Cheng-netizen21/STM32-ESP8266-Env-Monitor/docs/OTA写入成功图片.png

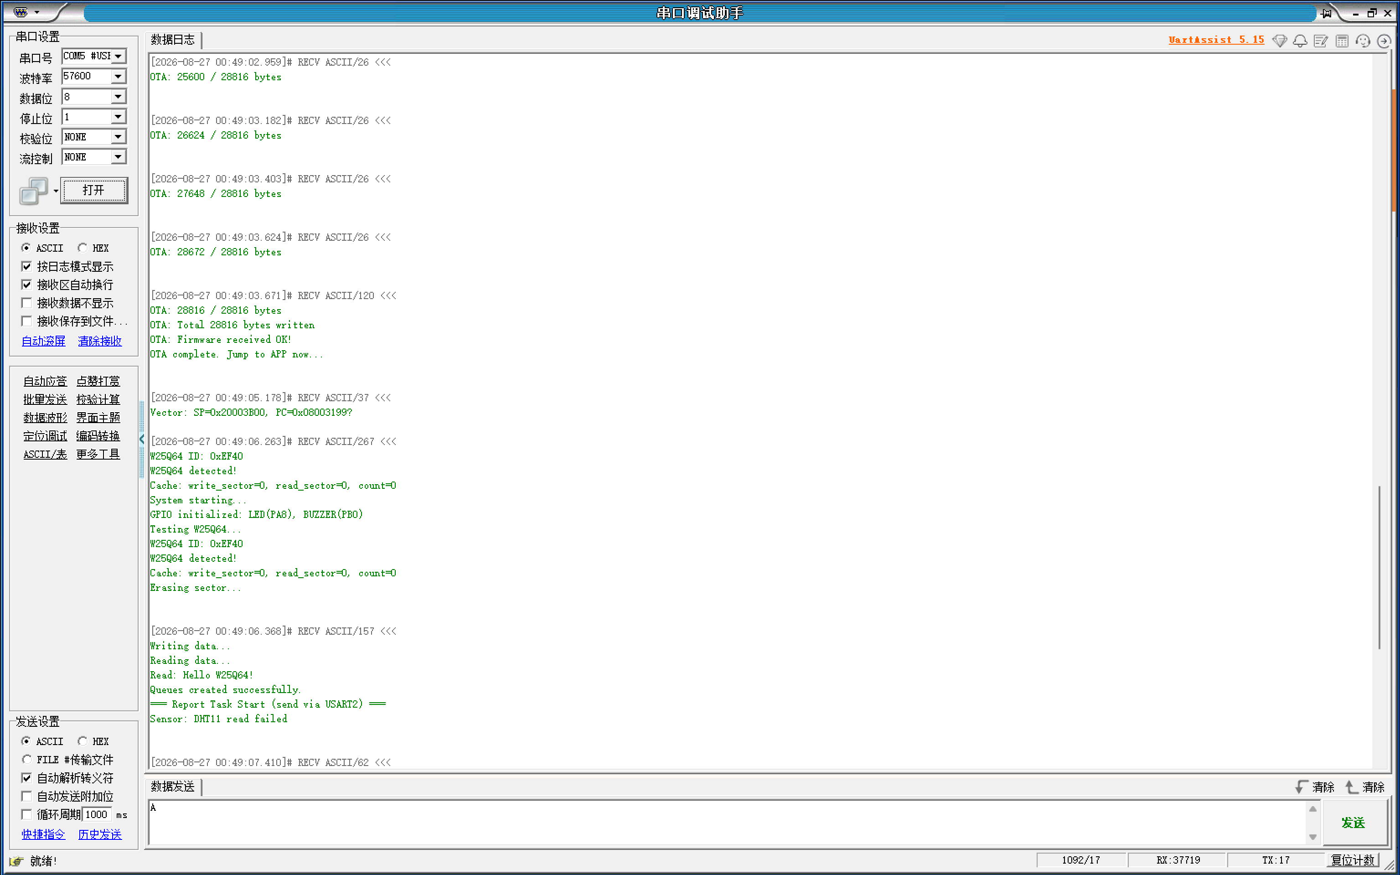
docs/OTA写入成功图片.png
