Cheng-netizen21/STM32-ESP8266-Env-Monitor/docs/光照强度对应值数据.png

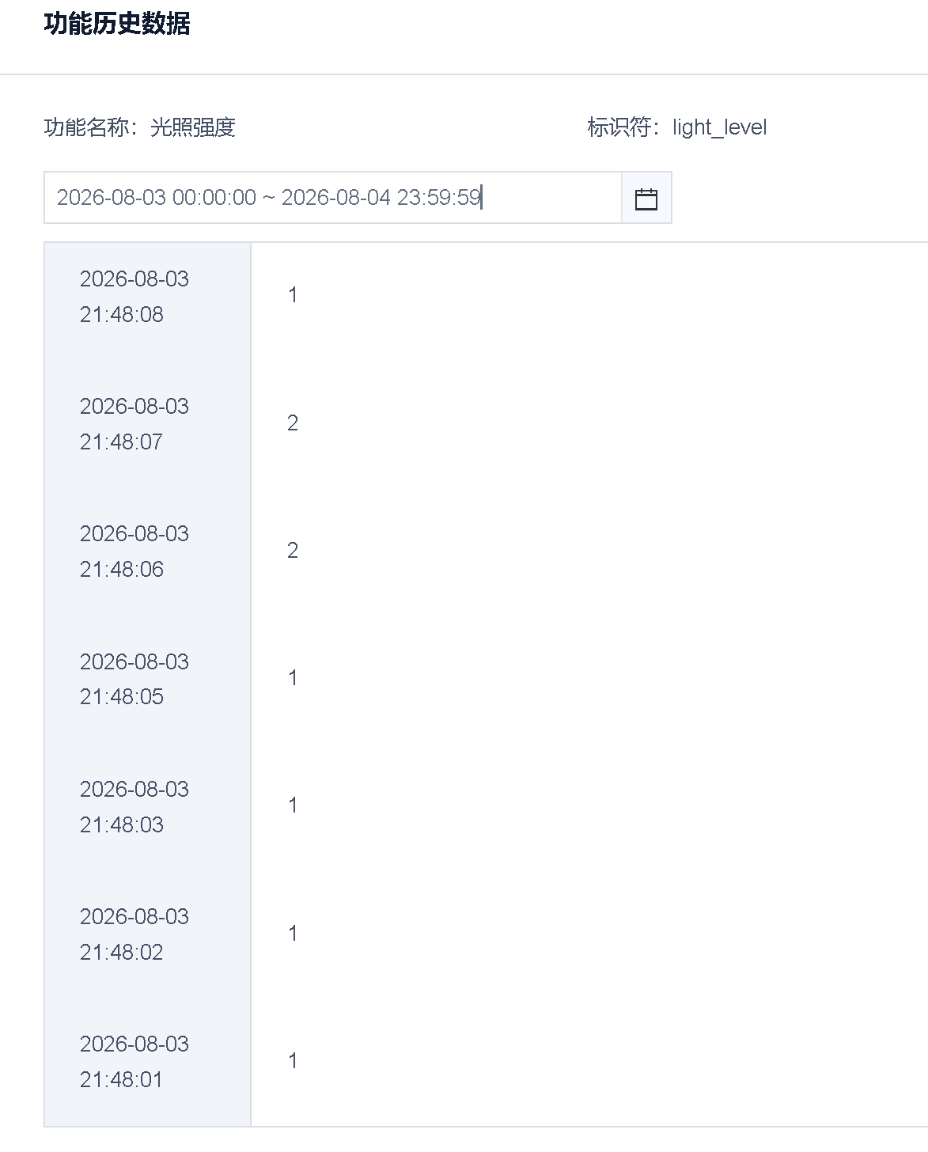
docs/光照强度对应值数据.png
