Cheng-netizen21/STM32-ESP8266-Env-Monitor/docs/架构图.png

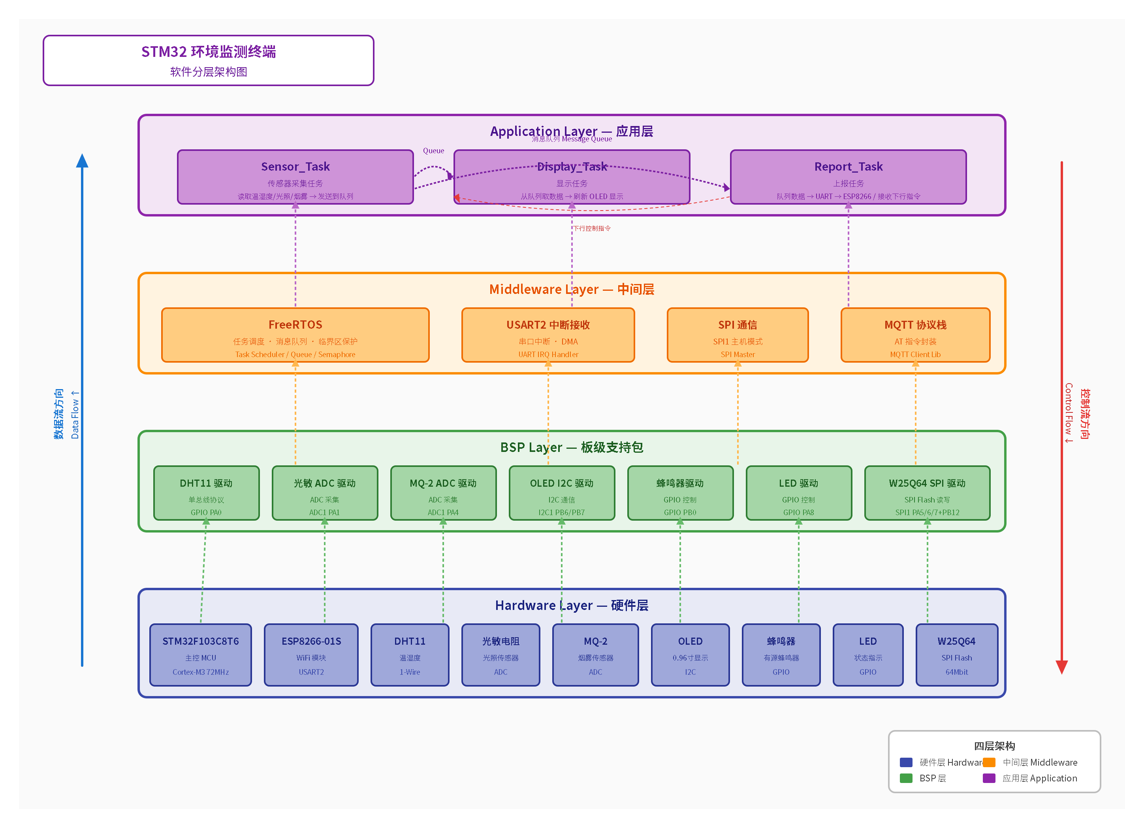
docs/架构图.png
