Cheng-netizen21/STM32-ESP8266-Env-Monitor/docs/温度波形图.png

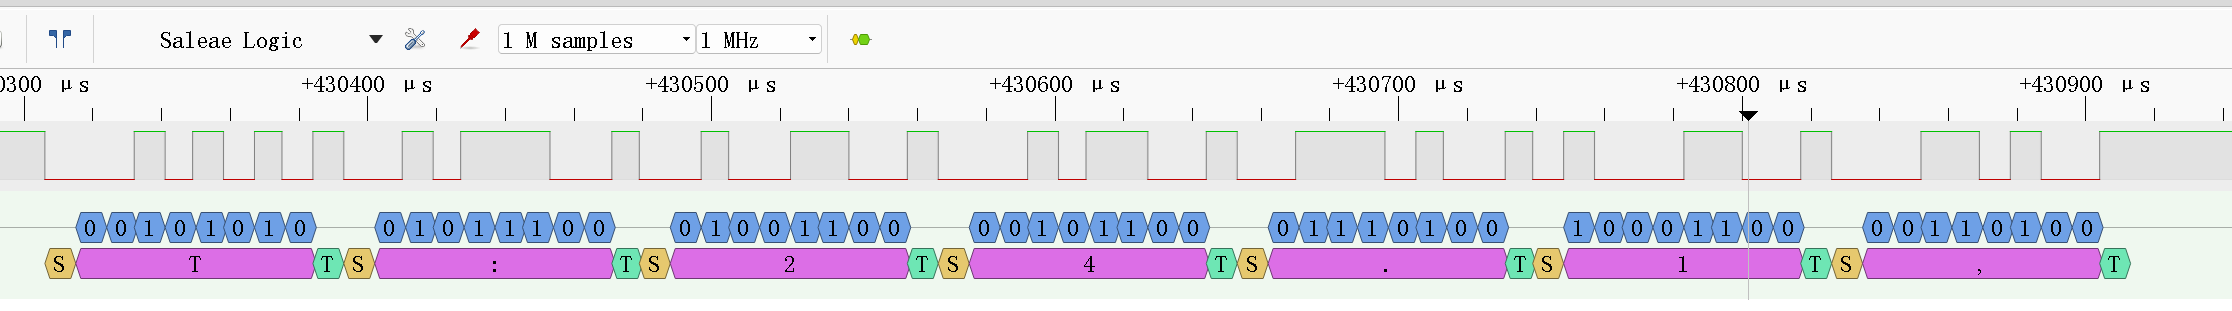
docs/温度波形图.png
