Cheng-netizen21/STM32-ESP8266-Env-Monitor/docs/湿度光照波形图.png

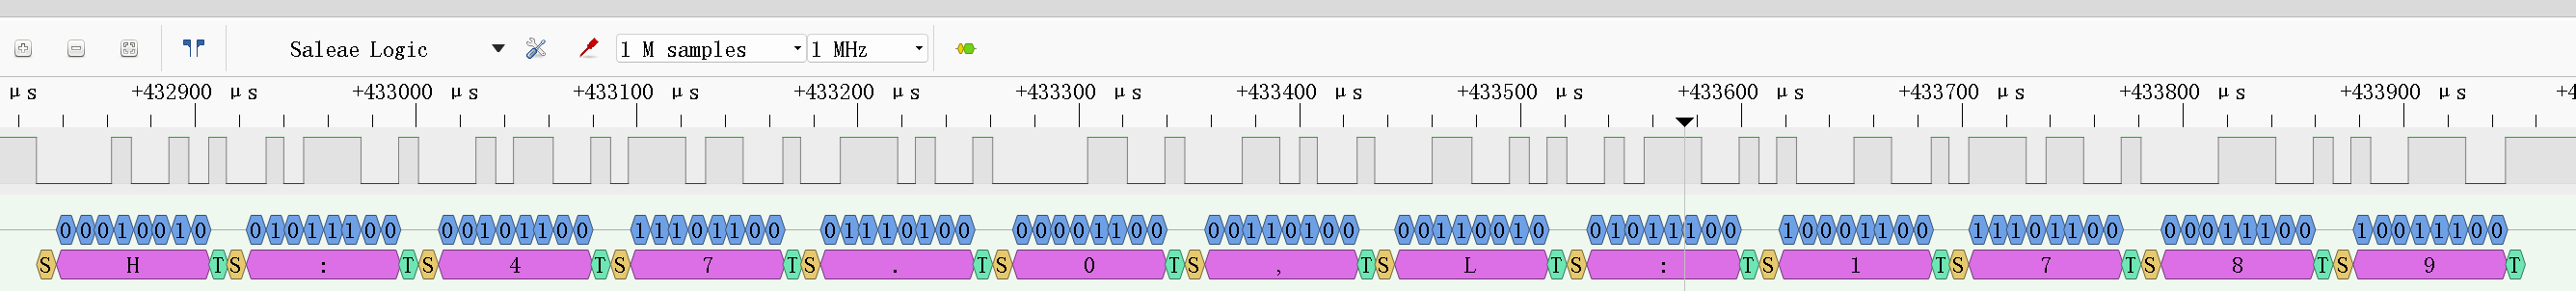
docs/湿度光照波形图.png
