Cheng-netizen21/STM32-ESP8266-Env-Monitor/docs/湿度曲线.png

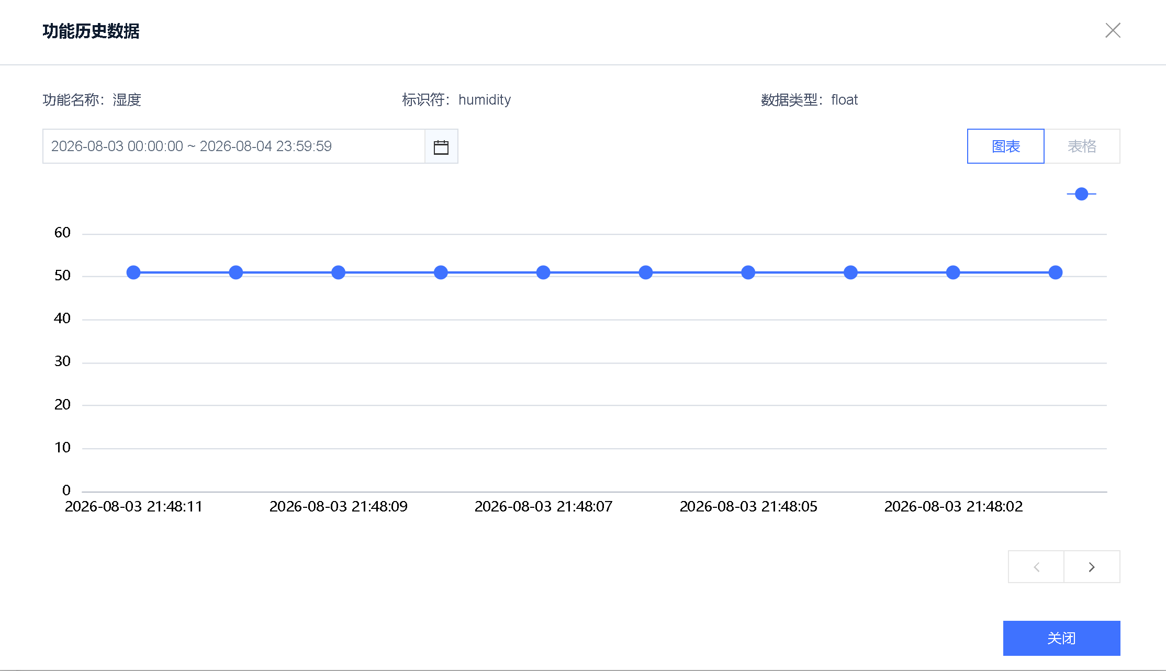
docs/湿度曲线.png
