Cheng-netizen21/STM32-ESP8266-Env-Monitor/docs/烟雾波形图.png

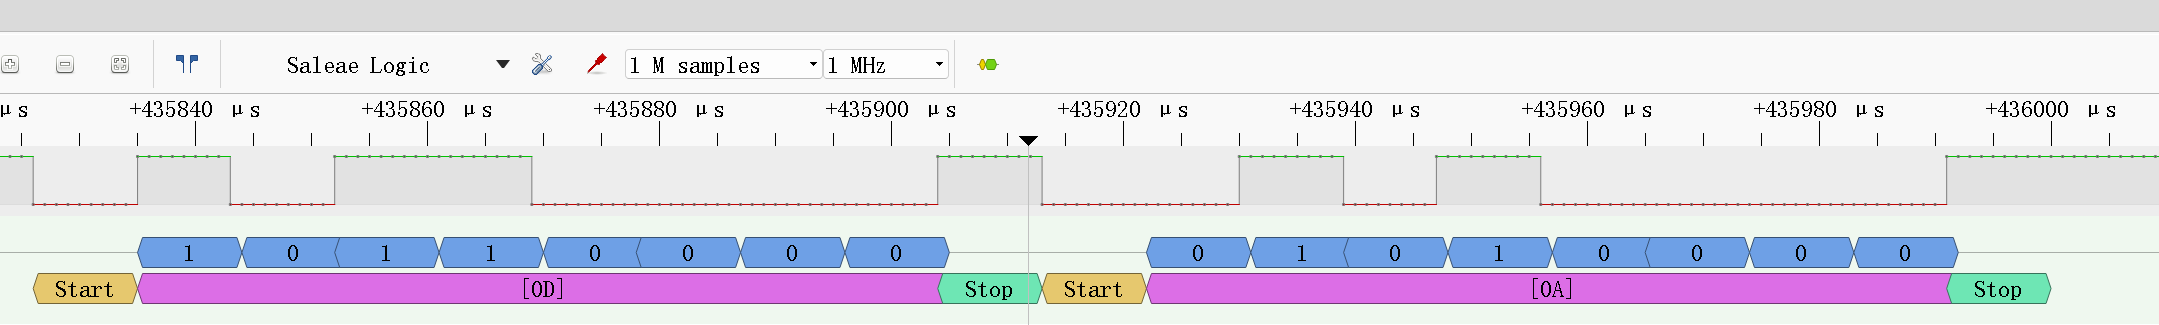
docs/烟雾波形图.png
