Cheng-netizen21/STM32-ESP8266-Env-Monitor/docs/硬件连接图.png

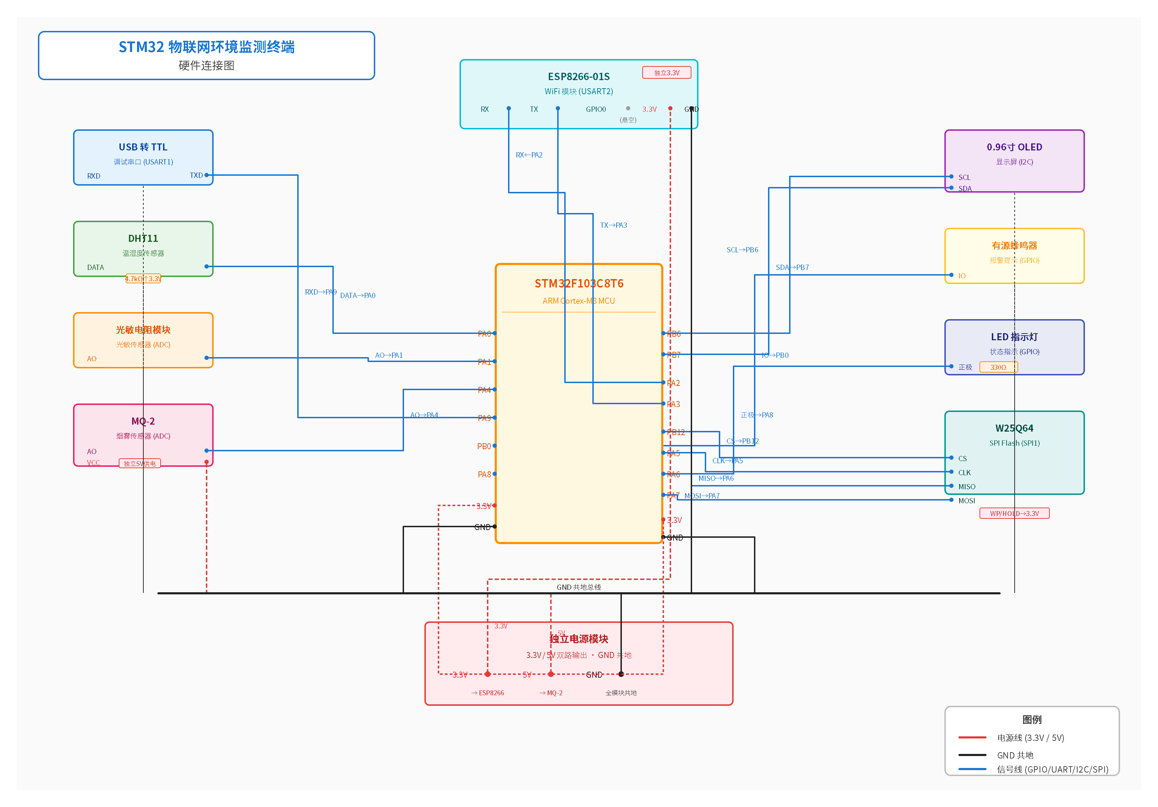
docs/硬件连接图.png
