Cheng-netizen21/STM32-ESP8266-Env-Monitor/STM32_Project/MyProject/MyProject/Core/Inc/main.h

#define KEY_INT_Pin GPIO_PIN_1
#define KEY_INT_GPIO_Port GPIOB
#define KEY_INT_EXTI_IRQn EXTI1_IRQn
#define FLASH_CS_Pin GPIO_PIN_12
#define FLASH_CS_GPIO_Port GPIOB
