Cheng-netizen21/STM32-ESP8266-Env-Monitor/STM32_Project/MyProject/MyProject/Core/Src/main.c

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
/* Includes ------------------------------------------------------------------*/
#include "main.h"
#include "cmsis_os.h"
#include "adc.h"
#include "spi.h"
#include "usart.h"
#include "gpio.h"

/* USER CODE BEGIN Includes */
#include "OLED.h"
#include "AD.h"
#include "DHT11.h"
#include <stdio.h>
#include "stm32f1xx_hal.h"        // HAL 总头文件，已包含 IWDG 定义
#include "w25q64.h"                // ====== 新增：W25Q64驱动 ======
/* USER CODE END Includes */

/* USER CODE BEGIN PD */
// ====== 新增：LED和蜂鸣器引脚定义 ======
#define LED_Pin     GPIO_PIN_8
#define LED_GPIO_Port   GPIOA
#define BUZZER_Pin  GPIO_PIN_0
#define BUZZER_GPIO_Port GPIOB
/* USER CODE END PD */


void SystemClock_Config(void);
void MX_FREERTOS_Init(void);
/* USER CODE BEGIN 0 */
extern osSemaphoreId_t keySemaphoreHandle;


// 独立看门狗初始化（直接操作寄存器）
void IWDG_Init(void)
{
    // 1. 使能写访问
    IWDG->KR = 0x5555;
    // 2. 设置预分频器为 64 (即 IWDG_PRESCALER_64)
    IWDG->PR = 4;   // 4 对应 64 分频
    // 3. 设置重装载值，超时约 2 秒 (LSI 约 40kHz，64分频后 625Hz，1250/625=2s)
    IWDG->RLR = 1250;
    // 4. 刷新计数值
    IWDG->KR = 0xAAAA;
    // 5. 启动看门狗
    IWDG->KR = 0xCCCC;
}

// 喂狗
void IWDG_Feed(void)
{
    IWDG->KR = 0xAAAA;
}

// ====== 自定义简单延时（替代 HAL_Delay） ======
static void delay_ms_simple(uint32_t ms)
{
    for (volatile uint32_t i = 0; i < ms * 6000; i++);
}
/* USER CODE END 0 */

/**
  * @brief  The application entry point.
  * @retval int
  */
int main(void)
{
  SCB->VTOR = 0x08003000;  //向量表迁移
  /* MCU Configuration--------------------------------------------------------*/

  /* Reset of all peripherals, Initializes the Flash interface and the Systick. */
  HAL_Init();

  /* Configure the system clock */
  SystemClock_Config();

  /* Initialize all configured peripherals */
  MX_GPIO_Init();
  MX_ADC1_Init();
  MX_USART1_UART_Init();
  MX_SPI1_Init();
  MX_USART2_UART_Init();
  /* USER CODE BEGIN 2 */
  delay_ms_simple(1000);   // 替换 HAL_Delay(1000)
  OLED_Init();
  AD_Init();
  DHT11_Init();
  W25Q64_Init(); 
  printf("System starting...\r\n");

  // ====== 新增：初始化LED和蜂鸣器GPIO ======
  GPIO_InitTypeDef GPIO_InitStruct = {0};
  
  // LED初始化（PA8推挽输出，默认低电平）
  GPIO_InitStruct.Pin = LED_Pin;
  GPIO_InitStruct.Mode = GPIO_MODE_OUTPUT_PP;
  GPIO_InitStruct.Pull = GPIO_NOPULL;
  GPIO_InitStruct.Speed = GPIO_SPEED_FREQ_HIGH;
  HAL_GPIO_Init(LED_GPIO_Port, &GPIO_InitStruct);
  HAL_GPIO_WritePin(LED_GPIO_Port, LED_Pin, GPIO_PIN_RESET);
  
  // 蜂鸣器初始化（PB0推挽输出，默认高电平——不响）
  GPIO_InitStruct.Pin = BUZZER_Pin;
  GPIO_InitStruct.Mode = GPIO_MODE_OUTPUT_PP;
  GPIO_InitStruct.Pull = GPIO_NOPULL;
  GPIO_InitStruct.Speed = GPIO_SPEED_FREQ_HIGH;
  HAL_GPIO_Init(BUZZER_GPIO_Port, &GPIO_InitStruct);
  HAL_GPIO_WritePin(BUZZER_GPIO_Port, BUZZER_Pin, GPIO_PIN_SET);
  
  printf("GPIO initialized: LED(PA8), BUZZER(PB0)\r\n");

  // ====== 新增：W25Q64 SPI Flash 测试 ======
  // 注意：如果不需要测试，可以注释掉下面这段
  {
      uint8_t write_buf[] = "Hello W25Q64!";
      uint8_t read_buf[20] = {0};
      
      printf("Testing W25Q64...\r\n");
      W25Q64_Init();
      
      printf("Erasing sector...\r\n");
      W25Q64_SectorErase(0x000000);
      
      printf("Writing data...\r\n");
      W25Q64_PageWrite(0x000000, write_buf, sizeof(write_buf));
      
      printf("Reading data...\r\n");
      W25Q64_ReadData(0x000000, read_buf, sizeof(write_buf));
      
      printf("Read: %s\r\n", read_buf);
  }

  // 初始化看门狗
  //IWDG_Init();
  /* USER CODE END 2 */

  /* Init scheduler */
  osKernelInitialize();  /* Call init function for freertos objects (in cmsis_os2.c) */
  MX_FREERTOS_Init();

  /* Start scheduler */
  osKernelStart();

  /* We should never get here as control is now taken by the scheduler */

  /* Infinite loop */
  /* USER CODE BEGIN WHILE */
  while (1)
  {
    /* USER CODE END WHILE */

    /* USER CODE BEGIN 3 */
  }
  /* USER CODE END 3 */
}

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
/* USER CODE BEGIN 4 */
void HAL_GPIO_EXTI_Callback(uint16_t GPIO_Pin)
{
    if (GPIO_Pin == GPIO_PIN_1)
    {
        BaseType_t xHigherPriorityTaskWoken = pdFALSE;
        osSemaphoreRelease(keySemaphoreHandle);
        portYIELD_FROM_ISR(xHigherPriorityTaskWoken);
    }
}
/* USER CODE END 4 */

/**
  * @brief  Period elapsed callback in non blocking mode
  * @note   This function is called  when TIM4 interrupt took place, inside
  * HAL_TIM_IRQHandler(). It makes a direct call to HAL_IncTick() to increment
  * a global variable "uwTick" used as application time base.
  * @param  htim : TIM handle
  * @retval None
  */
void HAL_TIM_PeriodElapsedCallback(TIM_HandleTypeDef *htim)
{
  if (htim->Instance == TIM4)
  {
    HAL_IncTick();
  }
}

/**
  * @brief  This function is executed in case of error occurrence.
  * @retval None
  */
void Error_Handler(void)
{
  /* USER CODE BEGIN Error_Handler_Debug */
  /* User can add his own implementation to report the HAL error return state */
  __disable_irq();
  while (1)
  {
  }
  /* USER CODE END Error_Handler_Debug */
}
#ifdef USE_FULL_ASSERT
/**
  * @brief  Reports the name of the source file and the source line number
  *         where the assert_param error has occurred.
  * @param  file: pointer to the source file name
  * @param  line: assert_param error line source number
  * @retval None
  */
void assert_failed(uint8_t *file, uint32_t line)
{
  /* USER CODE BEGIN 6 */
  /* User can add his own implementation to report the file name and line number,
     ex: printf("Wrong parameters value: file %s on line %d\r\n", file, line) */
  /* USER CODE END 6 */
}
#endif /* USE_FULL_ASSERT */
