Cheng-netizen21/STM32-ESP8266-Env-Monitor/(commit log)

2026-08-04 feat: 完成物联网环境监测终端（双MCU架构+MQTT+OTA+断网续传）
2026-08-30 Enhance README with OTA upgrade mechanism details
    Added a section on the OTA remote upgrade mechanism for STM32 and ESP8266, detailing the OTA process including IAP startup, handshake protocol, firmware transfer, and network reconnection.
