Cheng-netizen21/STM32-ESP8266-Env-Monitor/(notices)

Notices in the files:
STM32_Project/MyProject/MyProject/Core/Src/usart.c:
Copyright (c) 2026 STMicroelectronics.
All rights reserved.
This software is licensed under terms that can be found in the LICENSE file
README.md:
License: MIT
